OliWozniak/uMule/electronics/Układ odbiorników IR/Układ odbiorników IR.png

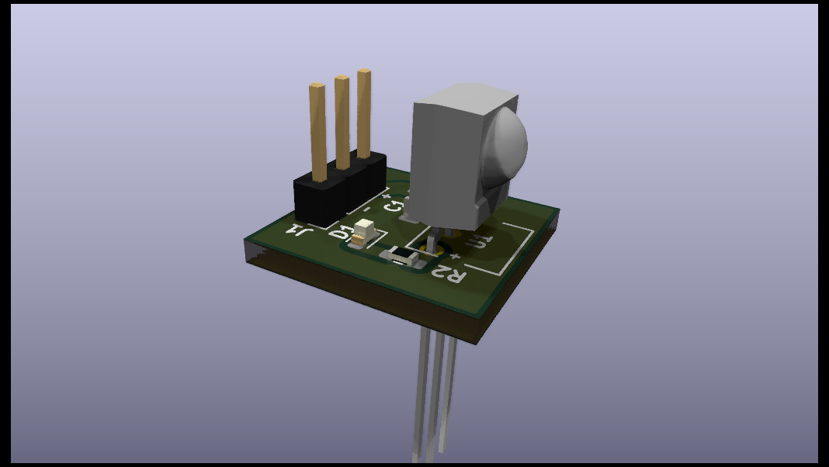
electronics/Układ odbiorników IR/Układ odbiorników IR.png
