OliWozniak/uMule/mechanics/subsets/attachments/raspberry_pi/raspberry-pi-5-case-4.snapshot.2/Perspective_4.jpg

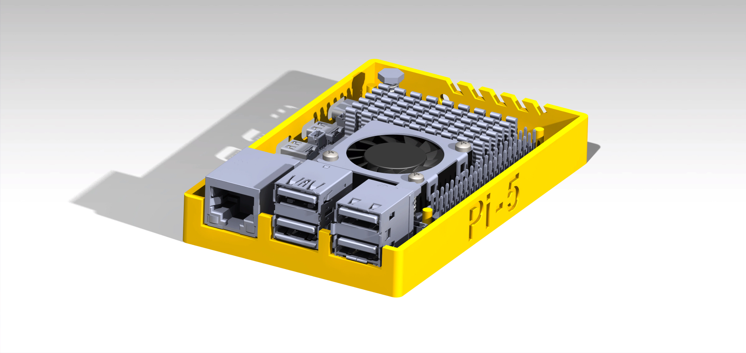
mechanics/subsets/attachments/raspberry_pi/raspberry-pi-5-case-4.snapshot.2/Perspective_4.jpg
