OliWozniak/uMule/electronics/Regulator_PD.drawio.pdf

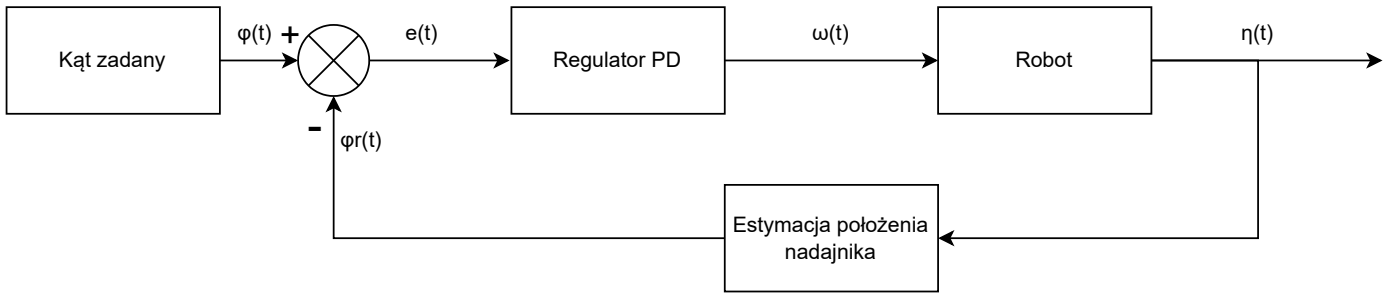
[picture p3: figure]
Estymacja położenia nadajnika; Regulator PD; Robot; Kąt zadany
