OliWozniak/uMule/electronics/Projekt elektroniki.png

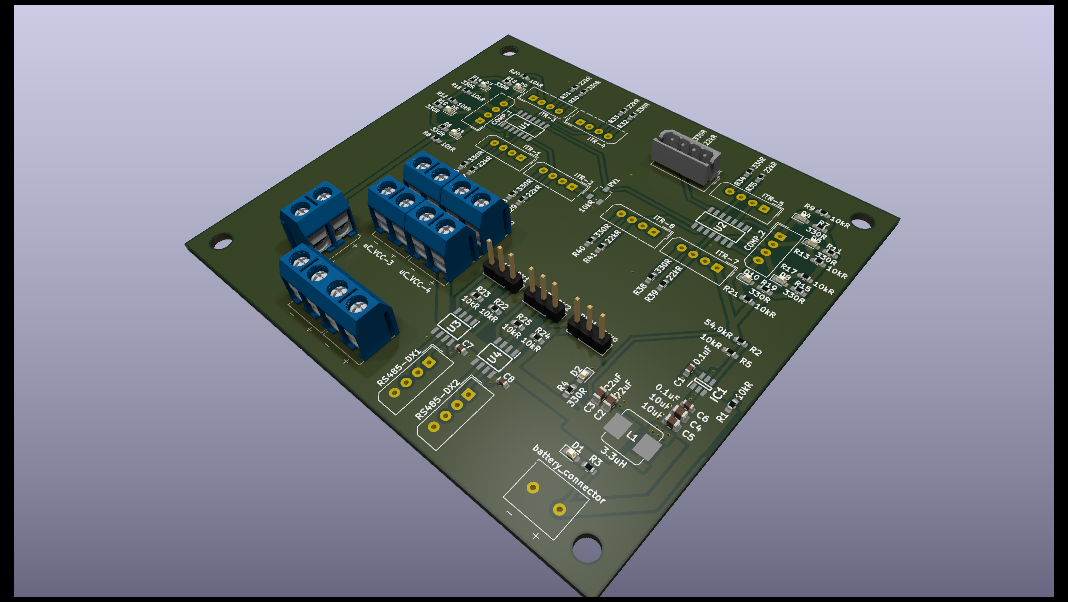
electronics/Projekt elektroniki.png
