OliWozniak/uMule/mechanics/hc-04-1.snapshot.5/HC-04.png

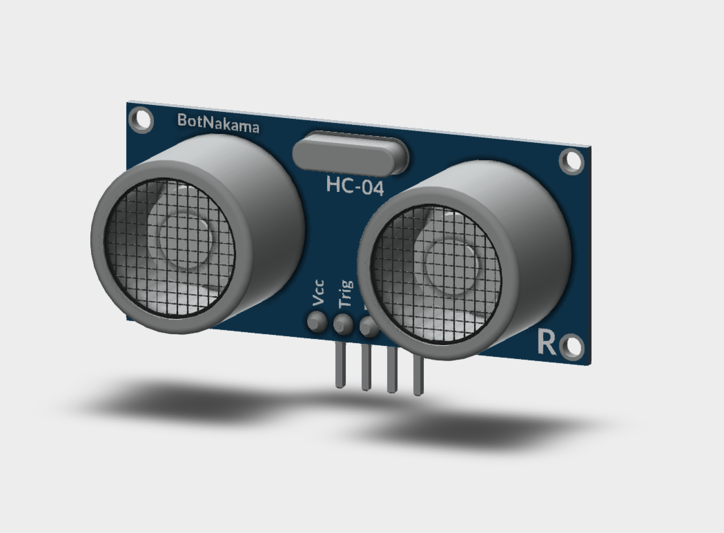
mechanics/hc-04-1.snapshot.5/HC-04.png
