OliWozniak/uMule/mechanics/subsets/attachments/raspberry_pi/raspberry-pi-5-case-4.snapshot.2/back-left.jpg

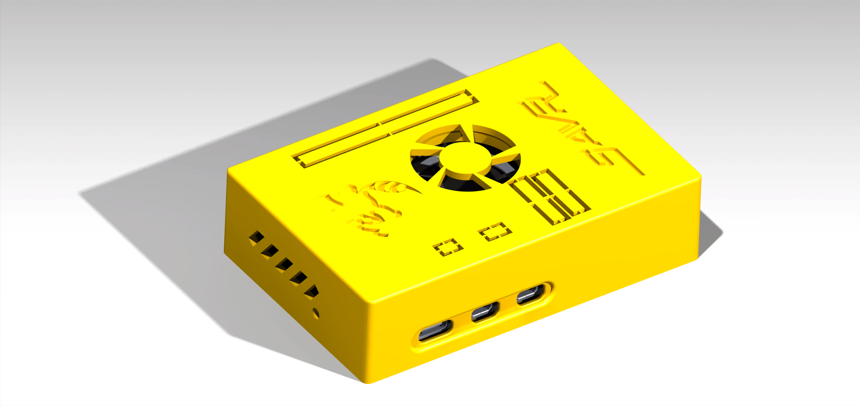
mechanics/subsets/attachments/raspberry_pi/raspberry-pi-5-case-4.snapshot.2/back-left.jpg
