OliWozniak/uMule/mechanics/subsets/power_pack/fg20451-lead-acid-battery-1.snapshot.1/FG20451.jpg

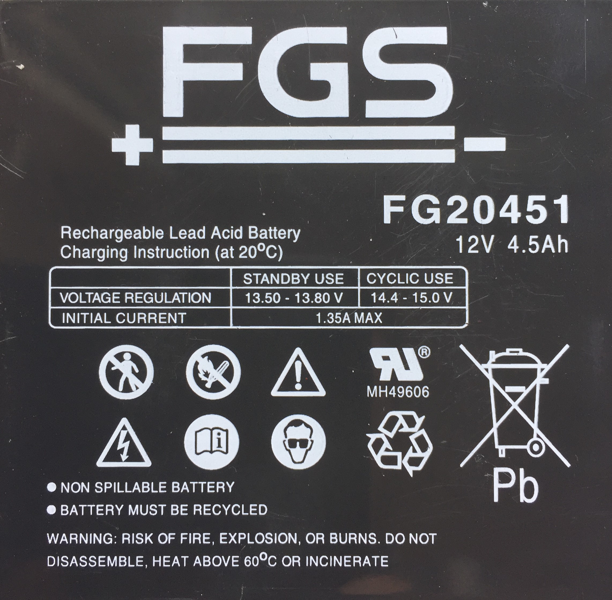
mechanics/subsets/power_pack/fg20451-lead-acid-battery-1.snapshot.1/FG20451.jpg
