OliWozniak/uMule/mechanics/subsets/attachments/raspberry_pi/Raspberry_PI+fan/raspberry-pi-5-active-cooler-1.snapshot.1/final_assembly.SLDASM

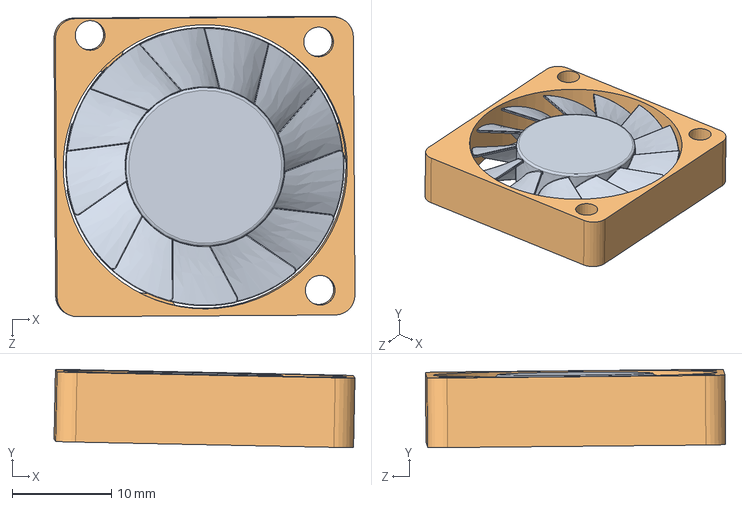
[picture p14: CAD file, 2026-05-02]
mechanics/subsets/attachments/raspberry_pi/Raspberry_PI+fan/raspberry-pi-5-active-cooler-1.snapshot.1/final_assembly.SLDASM
30.3 x 7.87 x 30.2 mm
RotorBlades
MotorHouse
