OliWozniak/uMule/mechanics/subsets/attachments/raspberry_pi/Raspberry_PI+fan/raspberry-pi-5-active-cooler-1.snapshot.1/Heatsink+fan RPi-5.SLDASM

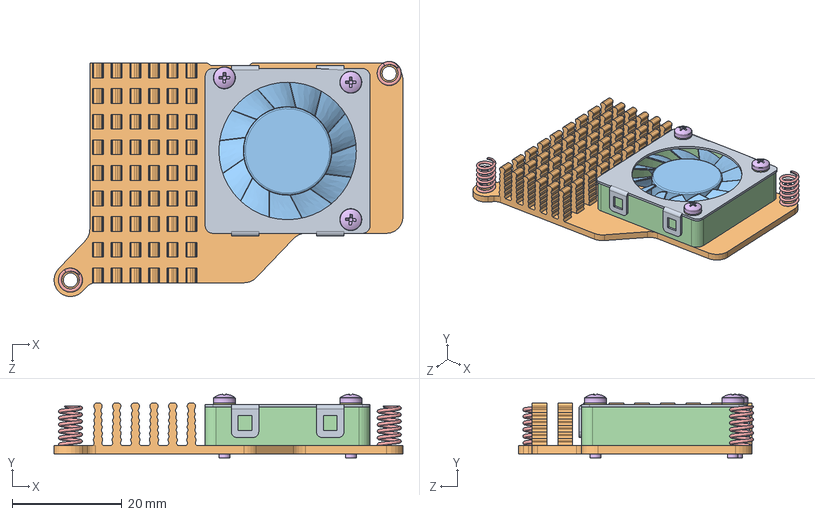
[picture p15: CAD file, 2026-05-02]
mechanics/subsets/attachments/raspberry_pi/Raspberry_PI+fan/raspberry-pi-5-active-cooler-1.snapshot.1/Heatsink+fan RPi-5.SLDASM
63.5 x 11.6 x 42.8 mm
Heatsink-fan-base_RPi5
RotorBlades
MotorHouse
fan cover
Spring x 2
pan head cross recess screw_din x 3
plain washer small grade a_din x 3
