OliWozniak/uMule/electronics/Importowane elementy/ARC_02-5mm/bornera.stp

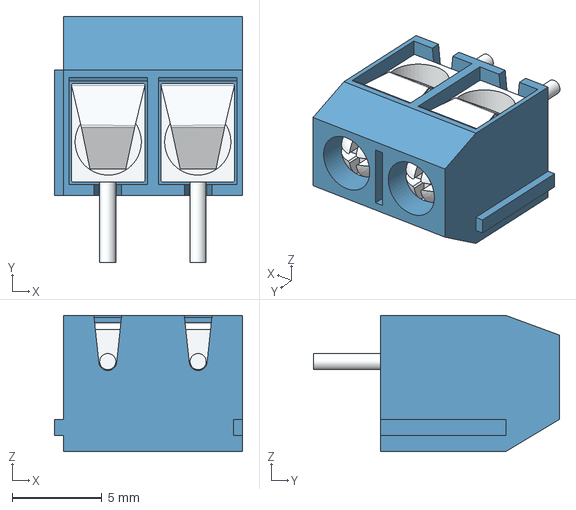
[picture p16: CAD file, 2024-11-24]
electronics/Importowane elementy/ARC_02-5mm/bornera.stp
10.5 x 13.8 x 7.60 mm
