OliWozniak/uMule/electronics/Importowane elementy/MAX485CSA+T/3D/MAX485CSA+T.stp

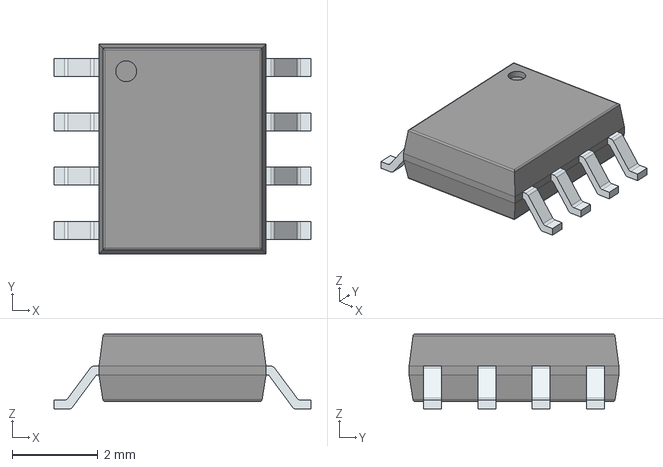
[picture p17: CAD file, 2024-11-24]
electronics/Importowane elementy/MAX485CSA+T/3D/MAX485CSA+T.stp
6.00 x 4.90 x 1.75 mm
PinsArrayLR
