OliWozniak/uMule/electronics/Importowane elementy/Molex-SPOX-04-2,5mm/3D/22-03-5045.stp

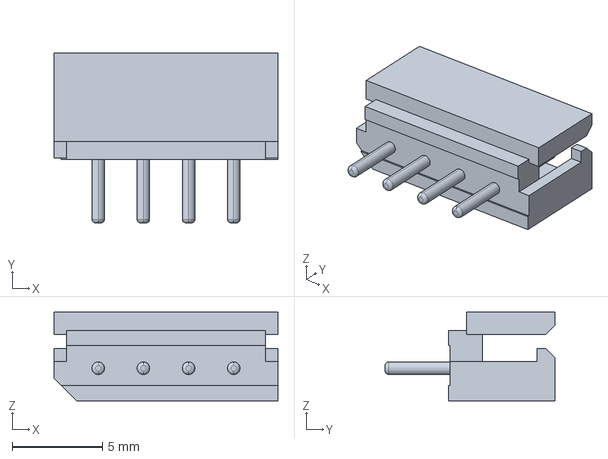
[picture p18: CAD file, 2024-11-24]
electronics/Importowane elementy/Molex-SPOX-04-2,5mm/3D/22-03-5045.stp
12.4 x 9.40 x 4.90 mm
