OliWozniak/uMule/electronics/Importowane elementy/TSOP4838/TSOP4838.stp

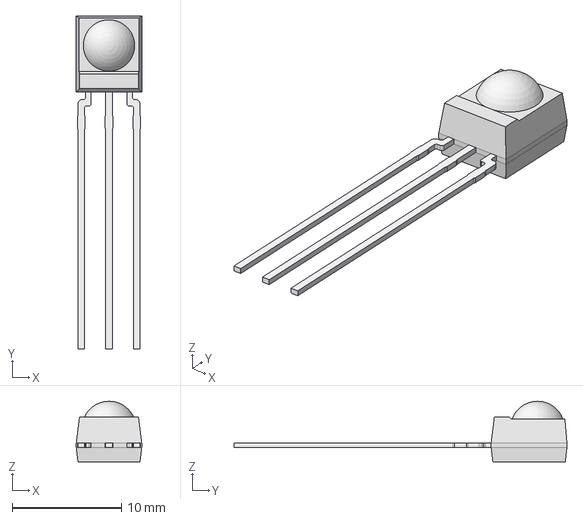
[picture p19: CAD file, 2024-11-24]
electronics/Importowane elementy/TSOP4838/TSOP4838.stp
6.00 x 30.5 x 5.55 mm
GO-100184
GO-100184.04
