OliWozniak/uMule/mechanics/hc-04-1.snapshot.5/HC-04HC-04.stl

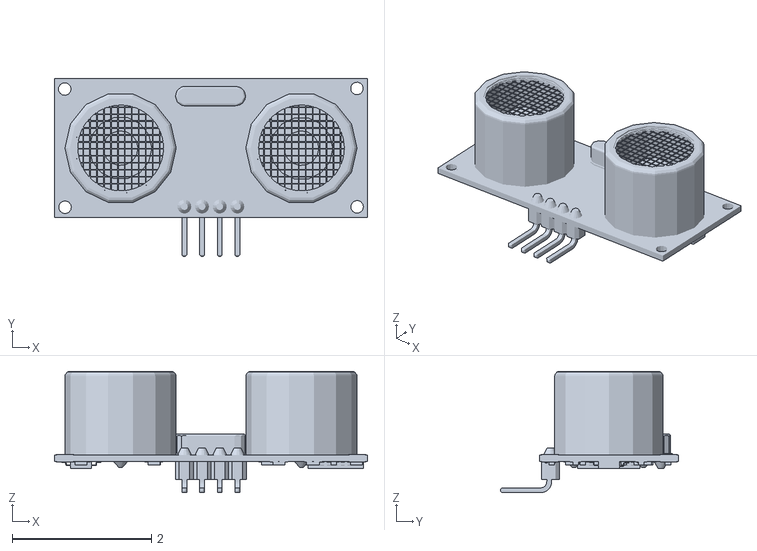
[picture p20: CAD file, 2024-11-24]
mechanics/hc-04-1.snapshot.5/HC-04HC-04.stl
4.50 x 2.56 x 1.75
