OliWozniak/uMule/mechanics/subsets/attachments/camera/camera_holder.step

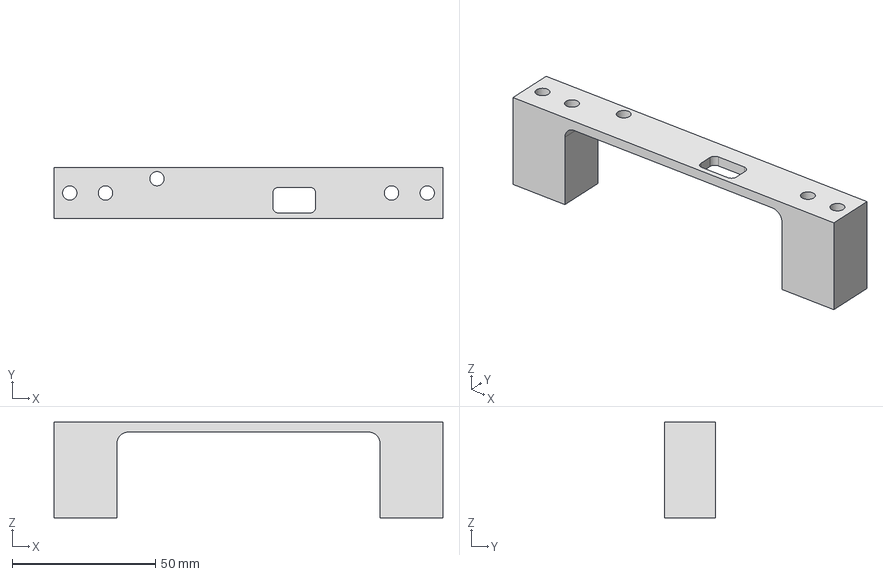
[picture p21: CAD file, 2026-05-04]
mechanics/subsets/attachments/camera/camera_holder.step
136.0 x 18.0 x 33.5 mm
