OliWozniak/uMule/mechanics/subsets/attachments/hub/attachments_hub.stp

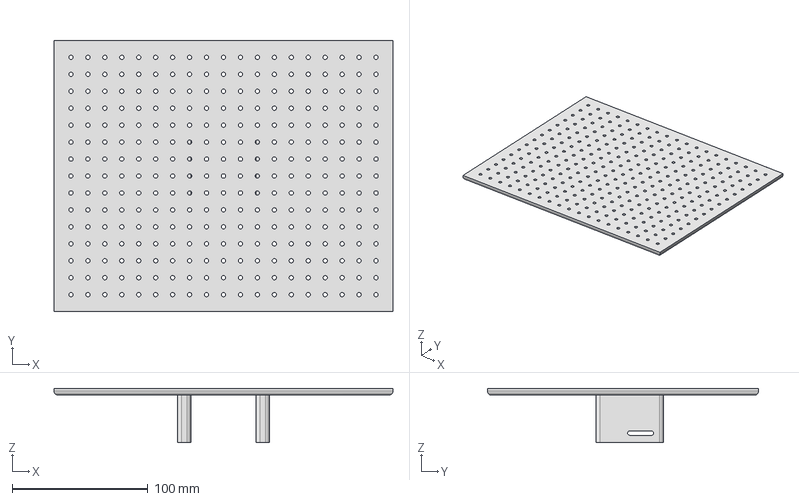
[picture p22: CAD file, 2026-05-04]
mechanics/subsets/attachments/hub/attachments_hub.stp
250.0 x 200.0 x 40.0 mm
