OliWozniak/uMule/mechanics/subsets/attachments/lidar/lidar_holder.stp

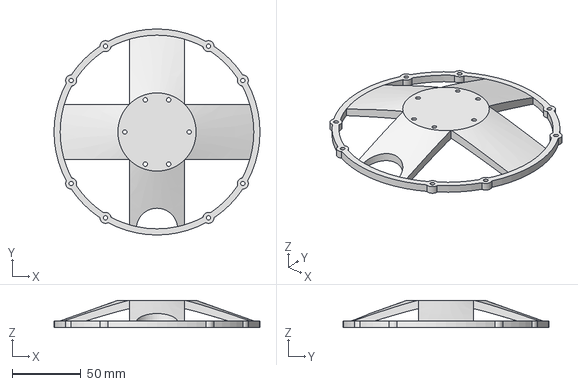
[picture p23: CAD file, 2026-05-04]
mechanics/subsets/attachments/lidar/lidar_holder.stp
150.0 x 150.0 x 20.0 mm
