OliWozniak/uMule/mechanics/subsets/attachments/main_board/board_holder.stp

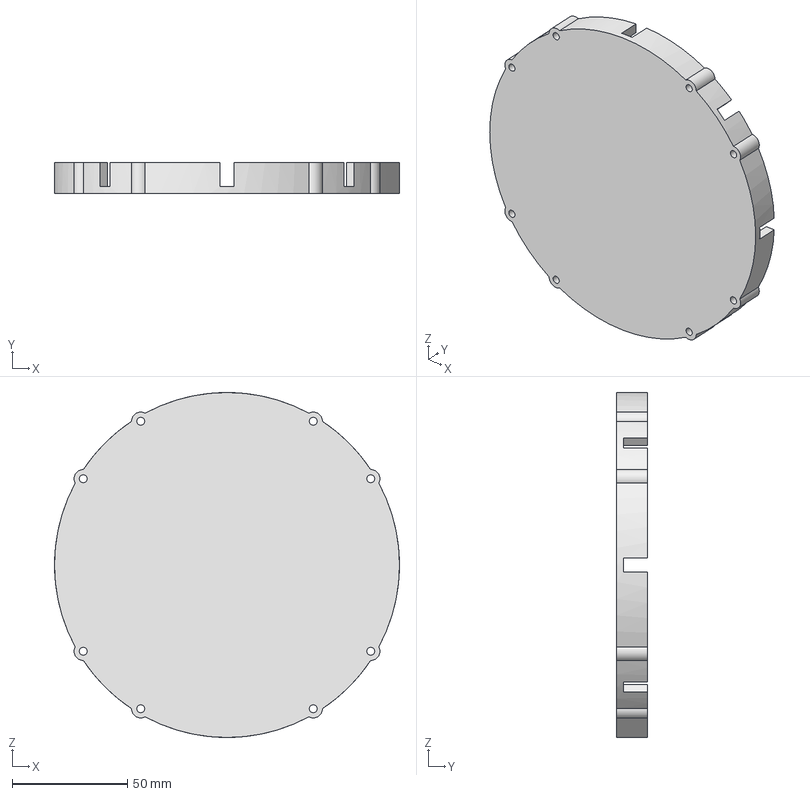
[picture p24: CAD file, 2026-05-04]
mechanics/subsets/attachments/main_board/board_holder.stp
150.0 x 13.5 x 150.0 mm
