OliWozniak/uMule/mechanics/subsets/attachments/print_files/RPi_case_bottom.stl

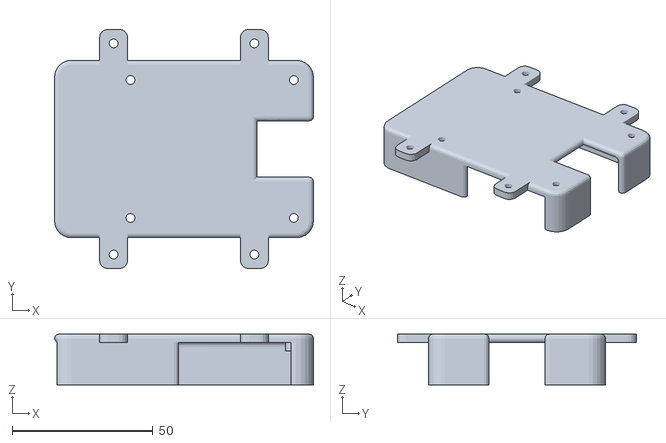
[picture p25: CAD file, 2026-05-04]
mechanics/subsets/attachments/print_files/RPi_case_bottom.stl
92.0 x 85.0 x 18.0
