OliWozniak/uMule/mechanics/subsets/attachments/raspberry_pi/raspberry-pi-5-case-4.snapshot.2/top.step

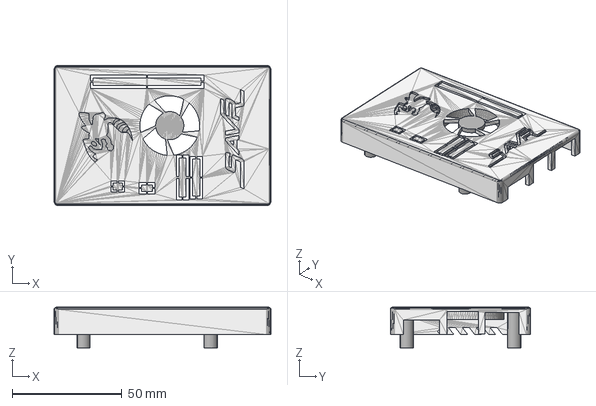
[picture p26: CAD file, 2026-05-04]
mechanics/subsets/attachments/raspberry_pi/raspberry-pi-5-case-4.snapshot.2/top.step
99.0 x 64.0 x 18.5 mm
