OliWozniak/uMule/mechanics/subsets/attachments/raspberry_pi/Raspberry_PI+fan/raspberry-pi-5-active-cooler-1.snapshot.1/Heatsink-fan-base_RPi5.SLDPRT

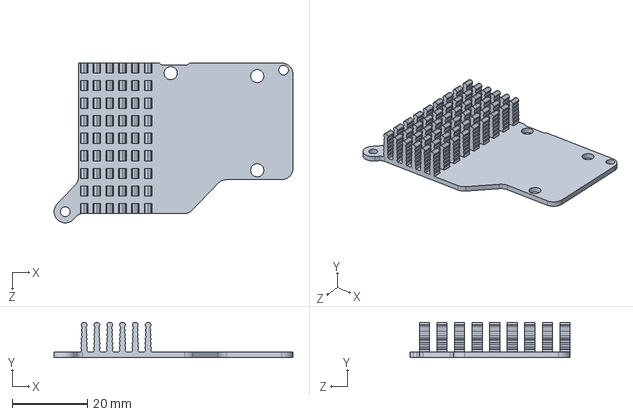
[picture p27: CAD file, 2026-05-02]
mechanics/subsets/attachments/raspberry_pi/Raspberry_PI+fan/raspberry-pi-5-active-cooler-1.snapshot.1/Heatsink-fan-base_RPi5.SLDPRT
63.5 x 9.30 x 42.5 mm
