OliWozniak/uMule/mechanics/subsets/attachments/print_files/lidar_holder.stl

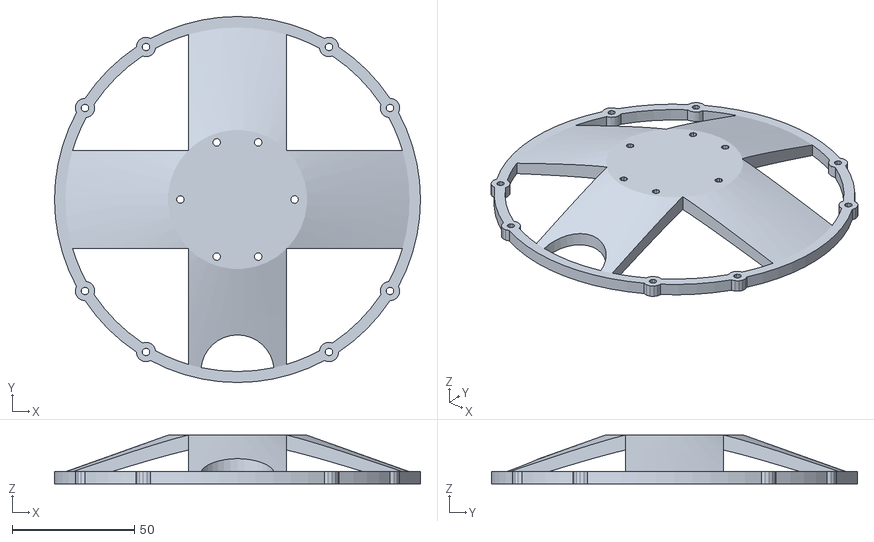
[picture p28: CAD file, 2026-05-04]
mechanics/subsets/attachments/print_files/lidar_holder.stl
150.0 x 150.0 x 20.0
