OliWozniak/uMule/mechanics/subsets/attachments/raspberry_pi/Raspberry_PI+fan/raspberry-pi-5-active-cooler-1.snapshot.1/MotorHouse.SLDPRT

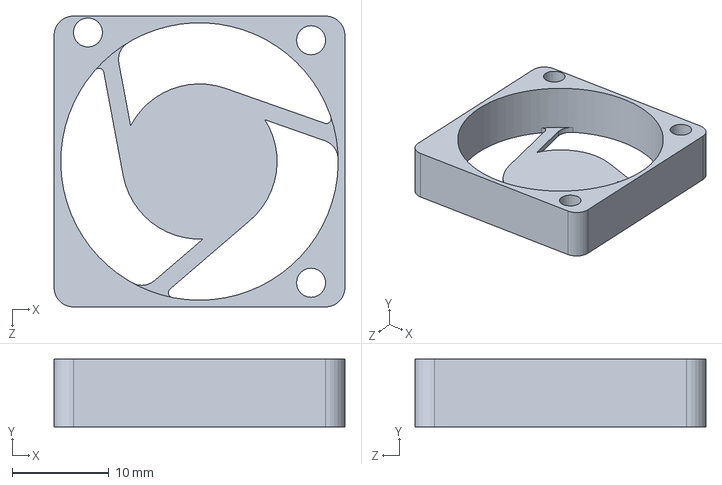
[picture p30: CAD file, 2026-05-02]
mechanics/subsets/attachments/raspberry_pi/Raspberry_PI+fan/raspberry-pi-5-active-cooler-1.snapshot.1/MotorHouse.SLDPRT
30.0 x 7.00 x 30.0 mm
