OliWozniak/uMule/mechanics/subsets/attachments/raspberry_pi/Raspberry_PI+fan/raspberry-pi-5-active-cooler-1.snapshot.1/fan cover.SLDPRT

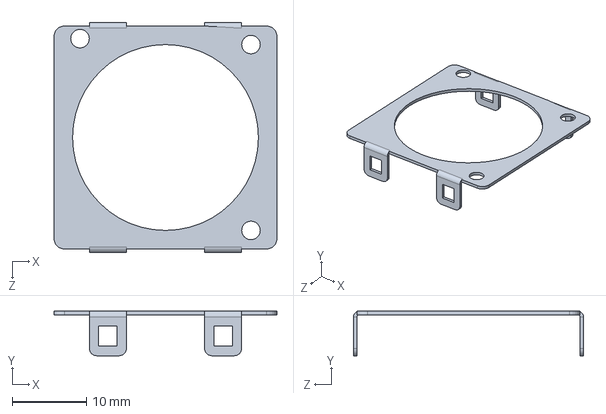
[picture p31: CAD file, 2026-05-02]
mechanics/subsets/attachments/raspberry_pi/Raspberry_PI+fan/raspberry-pi-5-active-cooler-1.snapshot.1/fan cover.SLDPRT
30.0 x 6.00 x 31.0 mm
