OliWozniak/uMule/(list of files, cad)

Other CAD files:
mechanics/subsets/attachments/raspberry_pi/RPi_case_bottom.stp
mechanics/subsets/attachments/print_files/board_holder.stl
mechanics/subsets/attachments/print_files/camera_holder.stl
mechanics/subsets/attachments/print_files/attachments_hub.stl
electronics/Importowane elementy/ARC_02-5mm/bornera.SLDPRT
mechanics/OldVersions/Część1.0002.ipt
mechanics/OldVersions/Pręt.0002.ipt
mechanics/OldVersions/pręt_długi.0002.ipt
mechanics/OldVersions/uMule-Koło.0018.iam
mechanics/OldVersions/uMule-UDaR-main_gear.0006.ipt
mechanics/OldVersions/uMule-UDaR-sensor.0003.ipt
mechanics/OldVersions/uMule-UDaR.0023.iam
mechanics/OldVersions/uMule-Uchwyt_koła.0004.ipt
mechanics/OldVersions/uMule-battery_case.0011.ipt
mechanics/OldVersions/uMule-battery_cover.0002.ipt
mechanics/OldVersions/uMule-elektronika.0008.iam
mechanics/OldVersions/uMule-kolo_napędowe.0004.ipt
mechanics/OldVersions/uMule-ogranicznik_koła.0012.ipt
mechanics/OldVersions/uMule-podstawa_elektronika-V1.1.0001.ipt
mechanics/OldVersions/uMule-podstawa_elektronika.0012.ipt
mechanics/OldVersions/uMule-podstawka_czujnikiIR.0006.ipt
mechanics/OldVersions/uMule-uchwyt_dx.0002.ipt
mechanics/OldVersions/uMule-uchwyt_dx_góra.0011.ipt
mechanics/OldVersions/uMule-uchwyt_servo.0004.ipt
mechanics/OldVersions/uMule_uchwyt-sens.0032.ipt
mechanics/subsets/attachments/camera/OldVersions/camera_assembly.0001.iam
mechanics/subsets/attachments/camera/OldVersions/camera_holder.0015.ipt
mechanics/subsets/attachments/camera/camera_assembly.iam
mechanics/subsets/attachments/camera/camera_holder.ipt
mechanics/subsets/attachments/camera/camera_model.ipt
mechanics/subsets/attachments/hub/OldVersions/attachments_hub.0010.ipt
mechanics/subsets/attachments/hub/attachments_hub.ipt
mechanics/subsets/attachments/lidar/LD19_v2/STL-19P_LiDaRLD19_PCB.ipt
mechanics/subsets/attachments/lidar/LD19_v2/STL-19P_LiDaRLD19_bottom.ipt
mechanics/subsets/attachments/lidar/LD19_v2/STL-19P_LiDaRLD19_middle.ipt
mechanics/subsets/attachments/lidar/LD19_v2/STL-19P_LiDaRLD19_up.ipt
mechanics/subsets/attachments/lidar/LD19_v2/STL-19P_LiDaRLD19_v2.iam
mechanics/subsets/attachments/lidar/LD19_v2/STL-19P_LiDaRPA2X6_1.ipt
mechanics/subsets/attachments/lidar/LD19_v2/STL-19P_LiDaRPA2X6_2.ipt
mechanics/subsets/attachments/lidar/LD19_v2/STL-19P_LiDaRPA2X6_3.ipt
mechanics/subsets/attachments/lidar/LD19_v2/STL-19P_LiDaRPA2X6_4.ipt
mechanics/subsets/attachments/lidar/OldVersions/lidar_holder.0005.ipt
mechanics/subsets/attachments/lidar/lidar_holder.ipt
mechanics/subsets/attachments/main_board/OldVersions/board_holder.0007.ipt
mechanics/subsets/attachments/main_board/OldVersions/main_board.0006.iam
mechanics/subsets/attachments/main_board/board_holder.ipt
mechanics/subsets/attachments/main_board/main_board.iam
mechanics/subsets/attachments/main_board/uMule_board/.step 1.21.1.ipt
mechanics/subsets/attachments/main_board/uMule_board/AO_DFN-8-1EP_5.55x5.2mm_P1.27mm_EP4.12x4.6mm.iam
mechanics/subsets/attachments/main_board/uMule_board/CP_EIA-3528-21_Kemet-B.ipt
mechanics/subsets/attachments/main_board/uMule_board/C_0402_1005Metric.ipt
mechanics/subsets/attachments/main_board/uMule_board/C_0603_1608Metric.ipt
mechanics/subsets/attachments/main_board/uMule_board/C_0805_2012Metric.ipt
mechanics/subsets/attachments/main_board/uMule_board/Crystal_SMD_5032-2Pin_5.0x3.2mm.ipt
mechanics/subsets/attachments/main_board/uMule_board/D_SMA.ipt
mechanics/subsets/attachments/main_board/uMule_board/D_SOD-123F.ipt
mechanics/subsets/attachments/main_board/uMule_board/JST_XH_B4B-XH-A_1x04_P2.50mm_Vertical.ipt
mechanics/subsets/attachments/main_board/uMule_board/JST_XH_B6B-XH-A_1x06_P2.50mm_Vertical.ipt
mechanics/subsets/attachments/main_board/uMule_board/LED_0603_1608Metric.ipt
mechanics/subsets/attachments/main_board/uMule_board/LQFP-64_10x10mm_P0.5mm.ipt
mechanics/subsets/attachments/main_board/uMule_board/PhoenixContact_MCV_1,5_2-G-3.5_1x02_P3.50mm_Vertical.ipt
mechanics/subsets/attachments/main_board/uMule_board/PinHeader_1x04_P2.54mm_Vertical.ipt
mechanics/subsets/attachments/main_board/uMule_board/PinHeader_2x04_P2.54mm_Vertical.ipt
mechanics/subsets/attachments/main_board/uMule_board/PinHeader_2x07_P1.27mm_Vertical.ipt
mechanics/subsets/attachments/main_board/uMule_board/R_0603_1608Metric.ipt
mechanics/subsets/attachments/main_board/uMule_board/SOIC-8_3.9x4.9mm_P1.27mm.ipt
mechanics/subsets/attachments/main_board/uMule_board/SOT-223.ipt
mechanics/subsets/attachments/main_board/uMule_board/SOT-23-5.ipt
mechanics/subsets/attachments/main_board/uMule_board/SOT-23.ipt
mechanics/subsets/attachments/main_board/uMule_board/SOT-583-8.ipt
mechanics/subsets/attachments/main_board/uMule_board/SW_SPST_TL3342.ipt
mechanics/subsets/attachments/main_board/uMule_board/uMule_board.iam
mechanics/subsets/attachments/main_board/uMule_board/uMule_board_PCB.ipt
mechanics/subsets/attachments/main_board/uMule_board/uMule_board_silkscreen.ipt
mechanics/subsets/attachments/main_board/uMule_board/uMule_board_silkscreen_1.ipt
mechanics/subsets/attachments/main_board/uMule_board/uMule_board_soldermask.ipt
mechanics/subsets/attachments/main_board/uMule_board/uMule_board_soldermask_1.ipt
mechanics/subsets/attachments/raspberry_pi/OldVersions/RPI_assembly.0004.iam
mechanics/subsets/attachments/raspberry_pi/OldVersions/RPi_case_bottom.0008.ipt
mechanics/subsets/attachments/raspberry_pi/RPI_assembly.iam
mechanics/subsets/attachments/raspberry_pi/RPi_case_bottom.ipt
mechanics/subsets/attachments/raspberry_pi/Raspberry_PI+fan/RASPBERRY_PI_5_1/2.0_PIN_HEADER.ipt
mechanics/subsets/attachments/raspberry_pi/Raspberry_PI+fan/RASPBERRY_PI_5_1/2xUSB_2.0_PORT.ipt
mechanics/subsets/attachments/raspberry_pi/Raspberry_PI+fan/RASPBERRY_PI_5_1/2xUSB_3.0_PORT.ipt
mechanics/subsets/attachments/raspberry_pi/Raspberry_PI+fan/RASPBERRY_PI_5_1/3.0_PIN_HEADER_10.ipt
mechanics/subsets/attachments/raspberry_pi/Raspberry_PI+fan/RASPBERRY_PI_5_1/9FD77_D9WHV.ipt
mechanics/subsets/attachments/raspberry_pi/Raspberry_PI+fan/RASPBERRY_PI_5_1/BROADCOM_1.ipt
mechanics/subsets/attachments/raspberry_pi/Raspberry_PI+fan/RASPBERRY_PI_5_1/BUTTON_2.ipt
mechanics/subsets/attachments/raspberry_pi/Raspberry_PI+fan/RASPBERRY_PI_5_1/BUTTON_MINI.ipt
mechanics/subsets/attachments/raspberry_pi/Raspberry_PI+fan/RASPBERRY_PI_5_1/CAMERA_DISPLAY_1.ipt
mechanics/subsets/attachments/raspberry_pi/Raspberry_PI+fan/RASPBERRY_PI_5_1/CAMERA_DISPLAY_2.ipt
mechanics/subsets/attachments/raspberry_pi/Raspberry_PI+fan/RASPBERRY_PI_5_1/CARD_SLOT_METAL_PIN.ipt
mechanics/subsets/attachments/raspberry_pi/Raspberry_PI+fan/RASPBERRY_PI_5_1/CONNECT_V1.ipt
mechanics/subsets/attachments/raspberry_pi/Raspberry_PI+fan/RASPBERRY_PI_5_1/FEMALE_MICRO_HDMI_CONNECTOR.ipt
mechanics/subsets/attachments/raspberry_pi/Raspberry_PI+fan/RASPBERRY_PI_5_1/FEMALE_USB_CONNECTOR.ipt
mechanics/subsets/attachments/raspberry_pi/Raspberry_PI+fan/RASPBERRY_PI_5_1/GIGABIT_ETHERNET_PORT.ipt
mechanics/subsets/attachments/raspberry_pi/Raspberry_PI+fan/RASPBERRY_PI_5_1/GIGABIT_ETHERNET_TRANSCEIVE.ipt
mechanics/subsets/attachments/raspberry_pi/Raspberry_PI+fan/RASPBERRY_PI_5_1/Logo raspberry.ipt
mechanics/subsets/attachments/raspberry_pi/Raspberry_PI+fan/RASPBERRY_PI_5_1/METAL_PLATE..ipt
mechanics/subsets/attachments/raspberry_pi/Raspberry_PI+fan/RASPBERRY_PI_5_1/MxL.ipt
mechanics/subsets/attachments/raspberry_pi/Raspberry_PI+fan/RASPBERRY_PI_5_1/PART3_V1.ipt
mechanics/subsets/attachments/raspberry_pi/Raspberry_PI+fan/RASPBERRY_PI_5_1/PLATE_RASPBERRY_PI_5.ipt
mechanics/subsets/attachments/raspberry_pi/Raspberry_PI+fan/RASPBERRY_PI_5_1/RASPBERRY_PI_5_1.iam
mechanics/subsets/attachments/raspberry_pi/Raspberry_PI+fan/RASPBERRY_PI_5_1/RP1_CO_CONTROLLER.ipt
mechanics/subsets/attachments/raspberry_pi/Raspberry_PI+fan/RASPBERRY_PI_5_1/SD_CARD_V1.ipt
mechanics/subsets/attachments/raspberry_pi/Raspberry_PI+fan/RASPBERRY_PI_5_1/SLOT_CARD_ASM.iam
mechanics/subsets/attachments/raspberry_pi/Raspberry_PI+fan/RASPBERRY_PI_5_1/STOCK_1.ipt
mechanics/subsets/attachments/raspberry_pi/Raspberry_PI+fan/RASPBERRY_PI_5_1/STOCK_2.ipt
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
