OliWozniak/uMule/electronics/Układ odbiorników IR/Układ odbiorników IR.kicad_pcb

## KiCad design electronics/Układ odbiorników IR/Układ odbiorników IR.kicad_pcb (2024-11-24)

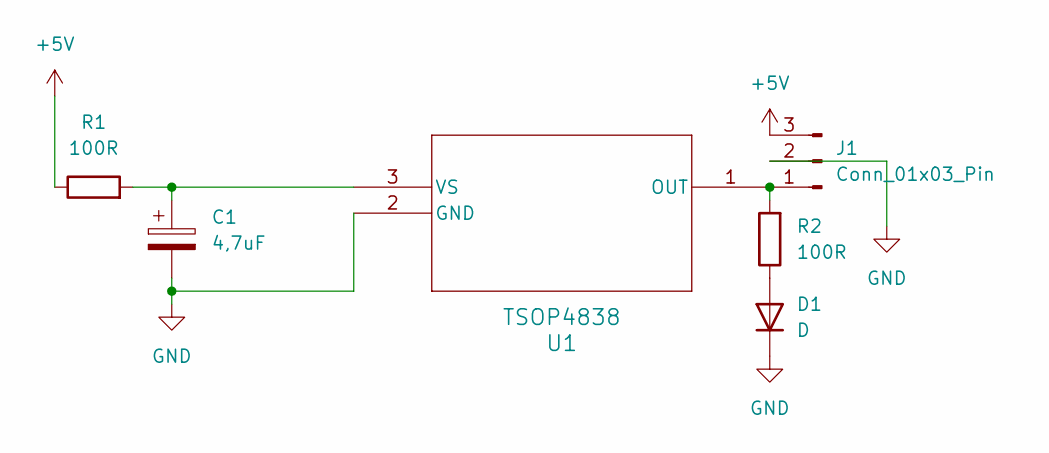
[picture p39: schematic Układ odbiorników IR.kicad_sch]

Parts:
C1: 4,7uF; C_0805_2012Metric_Pad1.18x1.45mm_HandSolder
D1: D; LED_0603_1608Metric
J1: Conn_01x03_Pin; PinHeader_1x03_P2.54mm_Vertical
R1, R2: 100R; R_0603_1608Metric_Pad0.98x0.95mm_HandSolder
U1: TSOP4838; TSOP48_VIS

Connections:
+5V: J1.3, R1.1
GND: C1.2, D1.1 (K), J1.2, U1.2 (GND)
unnamed: D1.2 (A), R2.1
unnamed: J1.1, R2.2, U1.1 (OUT)
unnamed: C1.1, R1.2, U1.3 (VS)

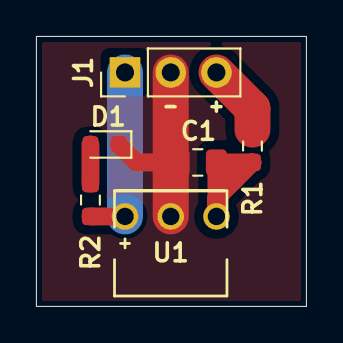
[picture p40: board Układ odbiorników IR.kicad_pcb from above]

Board: 2 copper layers, 15.0 x 15.0 mm, 6 parts (0 on the bottom side), 5 nets.
