OliWozniak/uMule/electronics/Projekt elektroniki.kicad_pcb

## KiCad design electronics/Projekt elektroniki.kicad_pcb (2024-11-24)

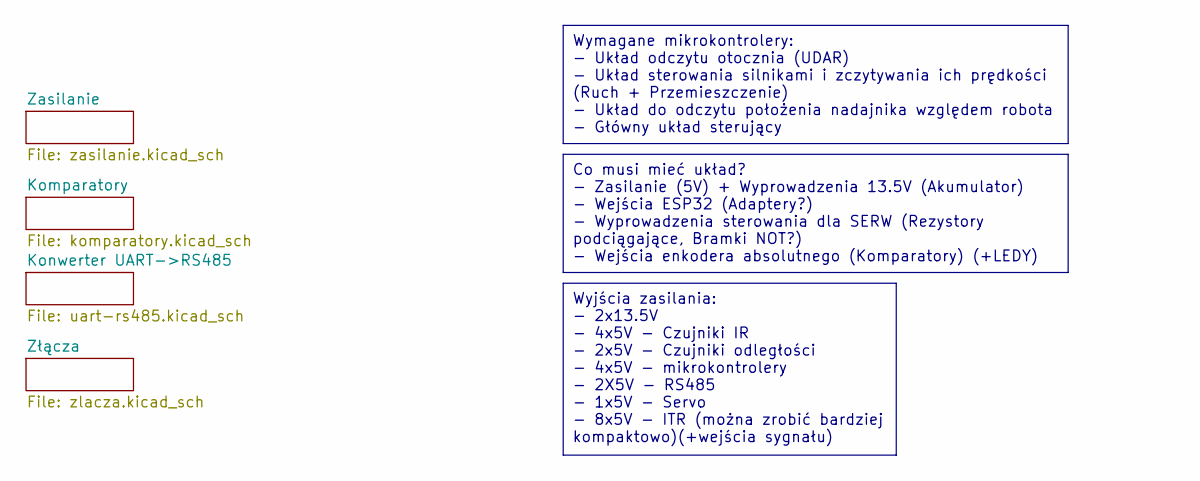
[picture p41: schematic Projekt elektroniki.kicad_sch]

Notes on the sheet:
Wyjścia zasilania: - 2x13.5V - 4x5V - Czujniki IR - 2x5V - Czujniki odległości - 4x5V - mikrokontrolery - 2X5V - RS485 - 1x5V - Servo - 8x5V - ITR (można zrobić bardziej kompaktowo)(+wejścia sygnału)
Wymagane mikrokontrolery: - Układ odczytu otocznia (UDAR) - Układ sterowania silnikami i zczytywania ich prędkości (Ruch + Przemieszczenie) - Układ do odczytu położenia nadajnika względem robota - Główny układ sterujący
Co musi mieć układ? - Zasilanie (5V) + Wyprowadzenia 13.5V (Akumulator) - Wejścia ESP32 (Adaptery?) - Wyprowadzenia sterowania dla SERW (Rezystory podciągające, Bramki NOT?) - Wejścia enkodera absolutnego (Komparatory) (+LEDY)

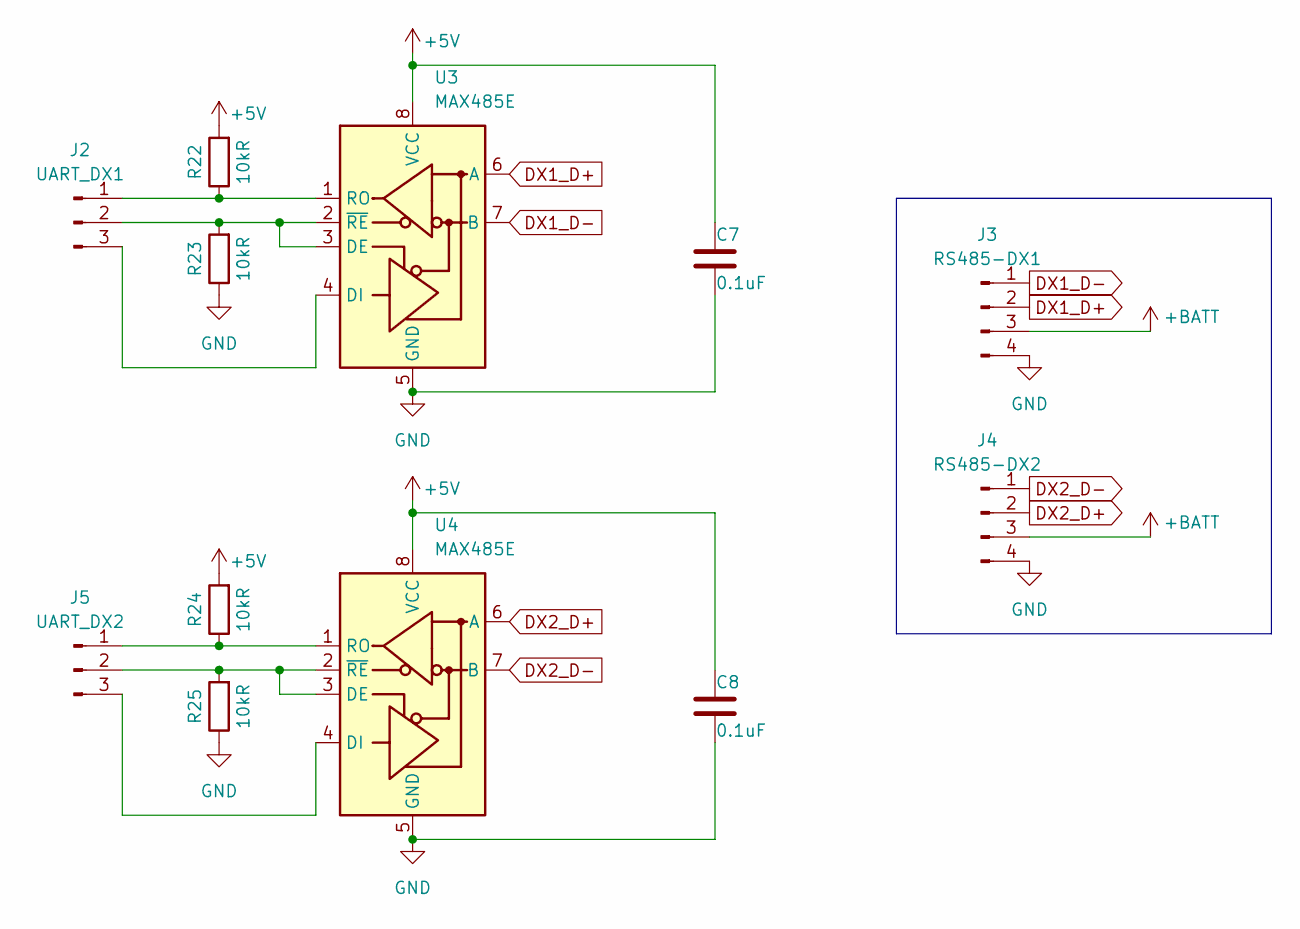
[picture p42: schematic uart-rs485.kicad_sch]

Parts:
C7, C8: 0.1uF; C_0603_1608Metric
J2: UART_DX1; PinHeader_1x03_P2.54mm_Vertical
J3: RS485-DX1; Molex_SPOX_5267-04A_1x04_P2.50mm_Vertical
J4: RS485-DX2; Molex_SPOX_5267-04A_1x04_P2.50mm_Vertical
J5: UART_DX2; PinHeader_1x03_P2.54mm_Vertical
R22, R23, R24, R25: 10kR; R_0603_1608Metric_Pad0.98x0.95mm_HandSolder
U3, U4: MAX485E; SOIC127P600X175-8N (MAX485)

Connections:
+5V: C7.2, C8.2, R22.2, R24.2, U3.8 (VCC), U4.8 (VCC); also elsewhere on the board
DX1_D+: J3.2, U3.6 (A)
DX1_D-: J3.1, U3.7 (B)
DX2_D+: J4.2, U4.6 (A)
DX2_D-: J4.1, U4.7 (B)
GND: C7.1, C8.1, J3.4, J4.4, R23.1, R25.1, U3.5 (GND), U4.5 (GND); also elsewhere on the board
unnamed: J2.1, R22.1, U3.1 (RO)
unnamed: J2.2, R23.2, U3.2 (~RE), U3.3 (DE)
unnamed: J2.3, U3.4 (DI)
unnamed: J5.1, R24.1, U4.1 (RO)
unnamed: J5.2, R25.2, U4.2 (~RE), U4.3 (DE)
unnamed: J5.3, U4.4 (DI)
Przetwornica_VIN: J3.3, J4.3; also elsewhere on the board

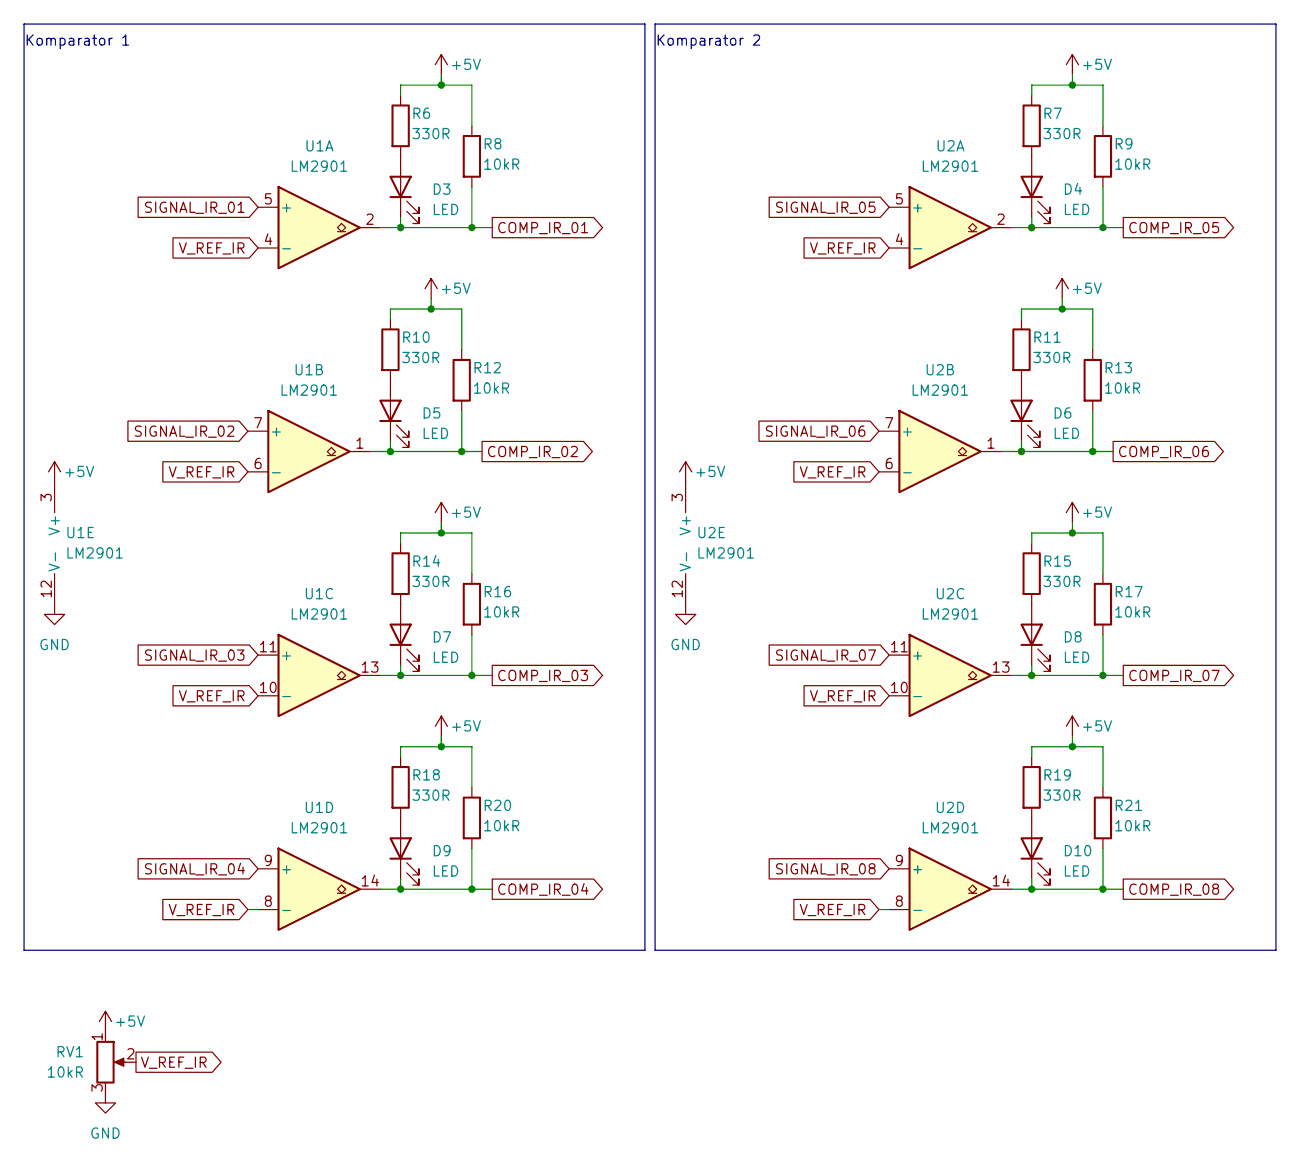
[picture p43: schematic komparatory.kicad_sch]

Parts:
D3, D4, D5, D6, D7, D8, D9, D10: LED; LED_0603_1608Metric_Pad1.05x0.95mm_HandSolder
R6, R7, R10, R11, R14, R15, R18, R19: 330R; R_0603_1608Metric_Pad0.98x0.95mm_HandSolder
R8, R9, R12, R13, R16, R17, R20, R21: 10kR; R_0603_1608Metric_Pad0.98x0.95mm_HandSolder
RV1: 10kR; Potencjometr 3,2x3,4
U1, U2: LM2901; SOIC127P600X175-14N

Connections:
+5V: R6.1, R7.1, R8.1, R9.1, R10.1, R11.1, R12.1, R13.1, R14.1, R15.1, R16.1, R17.1, R18.1, R19.1, R20.1, R21.1, RV1.1, U1.3 (V+), U2.3 (V+); also elsewhere on the board
COMP_IR_01: D3.1 (K), R8.2, U1.2; also elsewhere on the board
COMP_IR_02: D5.1 (K), R12.2, U1.1; also elsewhere on the board
COMP_IR_03: D7.1 (K), R16.2, U1.13; also elsewhere on the board
COMP_IR_04: D9.1 (K), R20.2, U1.14; also elsewhere on the board
COMP_IR_05: D4.1 (K), R9.2, U2.2; also elsewhere on the board
COMP_IR_06: D6.1 (K), R13.2, U2.1; also elsewhere on the board
COMP_IR_07: D8.1 (K), R17.2, U2.13; also elsewhere on the board
COMP_IR_08: D10.1 (K), R21.2, U2.14; also elsewhere on the board
GND: RV1.3, U1.12 (V-), U2.12 (V-); also elsewhere on the board
unnamed: D3.2 (A), R6.2
unnamed: D4.2 (A), R7.2
unnamed: D5.2 (A), R10.2
unnamed: D6.2 (A), R11.2
unnamed: D7.2 (A), R14.2
unnamed: D8.2 (A), R15.2
unnamed: D9.2 (A), R18.2
unnamed: D10.2 (A), R19.2
SIGNAL_IR_01: U1.5 (+); also elsewhere on the board
SIGNAL_IR_02: U1.7 (+); also elsewhere on the board
SIGNAL_IR_03: U1.11 (+); also elsewhere on the board
SIGNAL_IR_04: U1.9 (+); also elsewhere on the board
SIGNAL_IR_05: U2.5 (+); also elsewhere on the board
SIGNAL_IR_06: U2.7 (+); also elsewhere on the board
SIGNAL_IR_07: U2.11 (+); also elsewhere on the board
SIGNAL_IR_08: U2.9 (+); also elsewhere on the board
V_REF_IR: RV1.2, U1.4 (-), U1.6 (-), U1.8 (-), U1.10 (-), U2.4 (-), U2.6 (-), U2.8 (-), U2.10 (-)

Notes on the sheet:
Komparator 2
Komparator 1

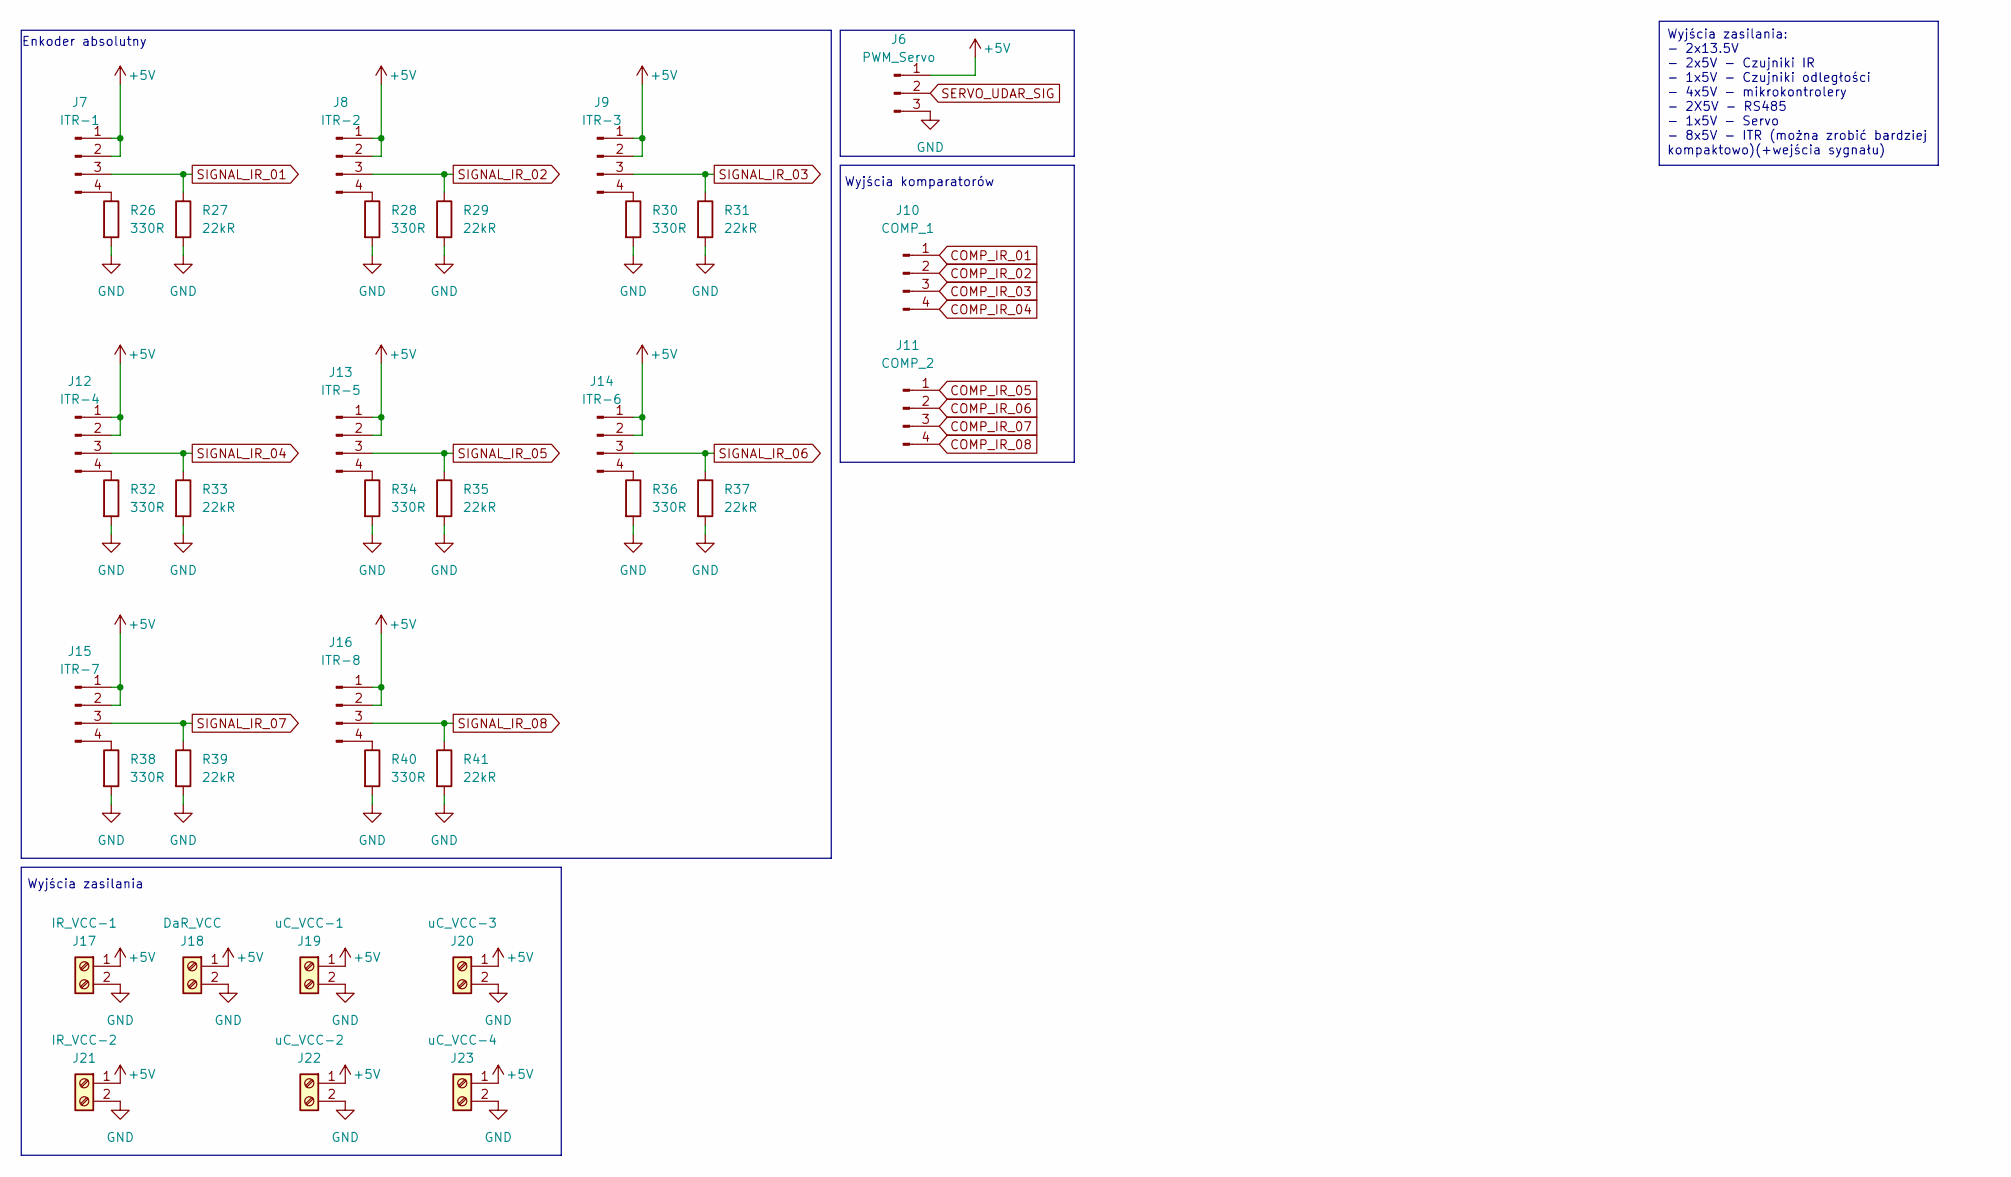
[picture p44: schematic zlacza.kicad_sch]

Parts:
J6: PWM_Servo; PinHeader_1x03_P2.54mm_Vertical
J7: ITR-1; Molex_SPOX_5267-04A_1x04_P2.50mm_Vertical
J8: ITR-2; Molex_SPOX_5267-04A_1x04_P2.50mm_Vertical
J9: ITR-3; Molex_SPOX_5267-04A_1x04_P2.50mm_Vertical
J10: COMP_1; Molex_SPOX_5267-04A_1x04_P2.50mm_Vertical
J11: COMP_2; Molex_SPOX_5267-04A_1x04_P2.50mm_Vertical
J12: ITR-4; Molex_SPOX_5267-04A_1x04_P2.50mm_Vertical
J13: ITR-5; Molex_SPOX_5267-04A_1x04_P2.50mm_Vertical
J14: ITR-6; Molex_SPOX_5267-04A_1x04_P2.50mm_Vertical
J15: ITR-7; Molex_SPOX_5267-04A_1x04_P2.50mm_Vertical
J16: ITR-8; Molex_SPOX_5267-04A_1x04_P2.50mm_Vertical
J17: IR_VCC-1; ARK 01x02 5mm
J18: DaR_VCC; ARK 01x02 5mm
J19: uC_VCC-1; ARK 01x02 5mm
J20: uC_VCC-3; ARK 01x02 5mm
J21: IR_VCC-2; ARK 01x02 5mm
J22: uC_VCC-2; ARK 01x02 5mm
J23: uC_VCC-4; ARK 01x02 5mm
R26, R28, R30, R32, R34, R36, R38, R40: 330R; R_0603_1608Metric_Pad0.98x0.95mm_HandSolder
R27, R29, R31, R33, R35, R37, R39, R41: 22kR; R_0603_1608Metric_Pad0.98x0.95mm_HandSolder

Connections:
+5V: J6.1, J7.1, J7.2, J8.1, J8.2, J9.1, J9.2, J12.1, J12.2, J13.1, J13.2, J14.1, J14.2, J15.1, J15.2, J16.1, J16.2, J17.1, J18.1, J19.1, J20.1, J21.1, J22.1, J23.1; also elsewhere on the board
COMP_IR_01: J10.1; also elsewhere on the board
COMP_IR_02: J10.2; also elsewhere on the board
COMP_IR_03: J10.3; also elsewhere on the board
COMP_IR_04: J10.4; also elsewhere on the board
COMP_IR_05: J11.1; also elsewhere on the board
COMP_IR_06: J11.2; also elsewhere on the board
COMP_IR_07: J11.3; also elsewhere on the board
COMP_IR_08: J11.4; also elsewhere on the board
GND: J6.3, J17.2, J18.2, J19.2, J20.2, J21.2, J22.2, J23.2, R26.2, R27.2, R28.2, R29.2, R30.2, R31.2, R32.2, R33.2, R34.2, R35.2, R36.2, R37.2, R38.2, R39.2, R40.2, R41.2; also elsewhere on the board
unnamed: J7.4, R26.1
unnamed: J8.4, R28.1
unnamed: J9.4, R30.1
unnamed: J12.4, R32.1
unnamed: J13.4, R34.1
unnamed: J14.4, R36.1
unnamed: J15.4, R38.1
unnamed: J16.4, R40.1
SERVO_UDAR_SIG: J6.2
SIGNAL_IR_01: J7.3, R27.1; also elsewhere on the board
SIGNAL_IR_02: J8.3, R29.1; also elsewhere on the board
SIGNAL_IR_03: J9.3, R31.1; also elsewhere on the board
SIGNAL_IR_04: J12.3, R33.1; also elsewhere on the board
SIGNAL_IR_05: J13.3, R35.1; also elsewhere on the board
SIGNAL_IR_06: J14.3, R37.1; also elsewhere on the board
SIGNAL_IR_07: J15.3, R39.1; also elsewhere on the board
SIGNAL_IR_08: J16.3, R41.1; also elsewhere on the board

Notes on the sheet:
Wyjścia zasilania: - 2x13.5V - 2x5V - Czujniki IR - 1x5V - Czujniki odległości - 4x5V - mikrokontrolery - 2X5V - RS485 - 1x5V - Servo - 8x5V - ITR (można zrobić bardziej kompaktowo)(+wejścia sygnału)
Wyjścia zasilania
Wyjścia komparatorów
Enkoder absolutny

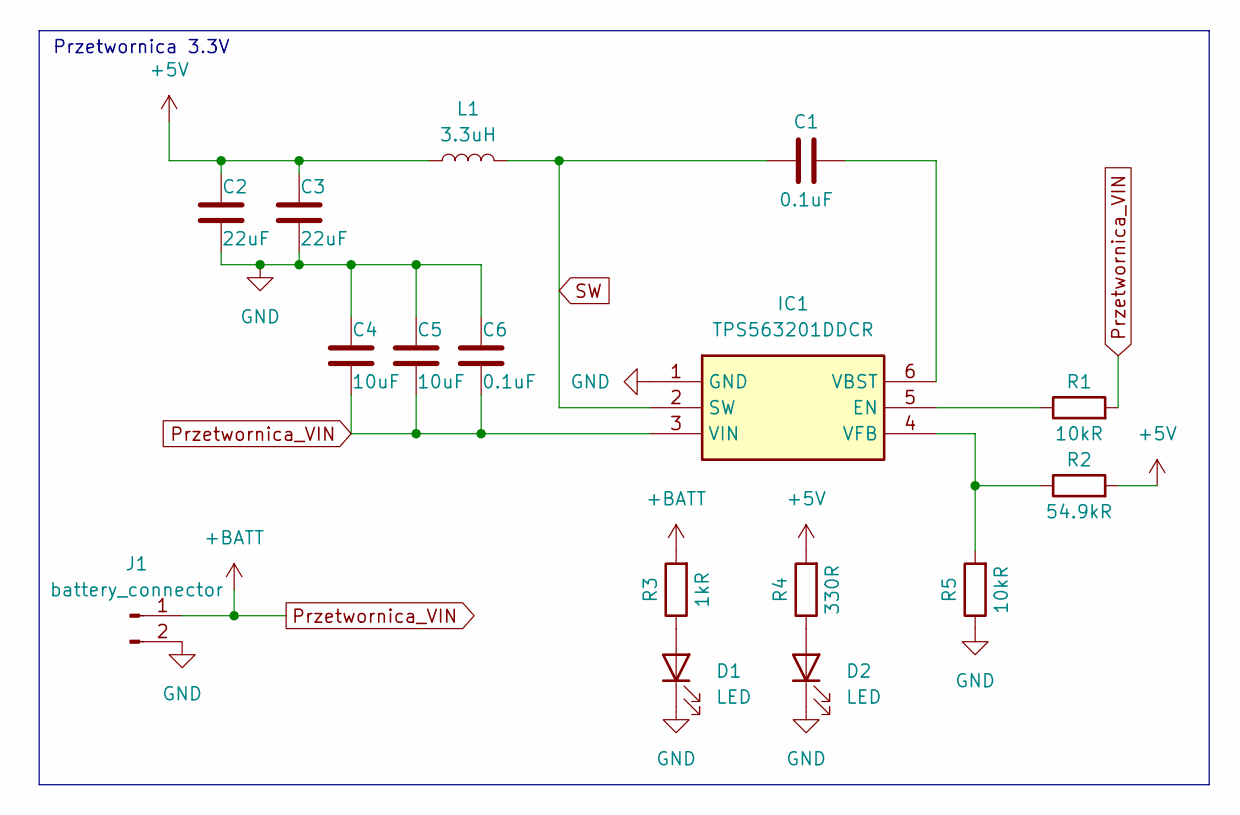
[picture p45: schematic zasilanie.kicad_sch]

Parts:
C1, C6: 0.1uF; C_0603_1608Metric
C2, C3: 22uF; C_0805_2012Metric
C4, C5: 10uF; C_0805_2012Metric
D1, D2: LED; LED_0603_1608Metric_Pad1.05x0.95mm_HandSolder
IC1: TPS563201DDCR; SOT95P280X110-6N; Manufacturer_Part_Number TPS563201DDCR
J1: battery_connector; ARK 01x02 5mm
L1: 3.3uH; L_Bourns_SRP7028A_7.3x6.6mm
R1, R5: 10kR; R_0603_1608Metric_Pad0.98x0.95mm_HandSolder
R2: 54.9kR; R_0603_1608Metric
R3: 1kR; R_0603_1608Metric
R4: 330R; R_0603_1608Metric_Pad0.98x0.95mm_HandSolder

Connections:
+5V: C2.2, C3.2, L1.1, R2.2, R4.2; also elsewhere on the board
GND: C2.1, C3.1, C4.2, C5.2, C6.2, D1.1 (K), D2.1 (K), IC1.1 (GND), J1.2, R5.1; also elsewhere on the board
unnamed: D1.2 (A), R3.1
unnamed: D2.2 (A), R4.1
unnamed: IC1.5 (EN), R1.1
unnamed: C1.2, IC1.6 (VBST)
unnamed: IC1.4 (VFB), R2.1, R5.2
Przetwornica_VIN: C4.1, C5.1, C6.1, IC1.3 (VIN), J1.1, R1.2, R3.2; also elsewhere on the board
SW: C1.1, IC1.2 (SW), L1.2

Notes on the sheet:
Przetwornica 3.3V

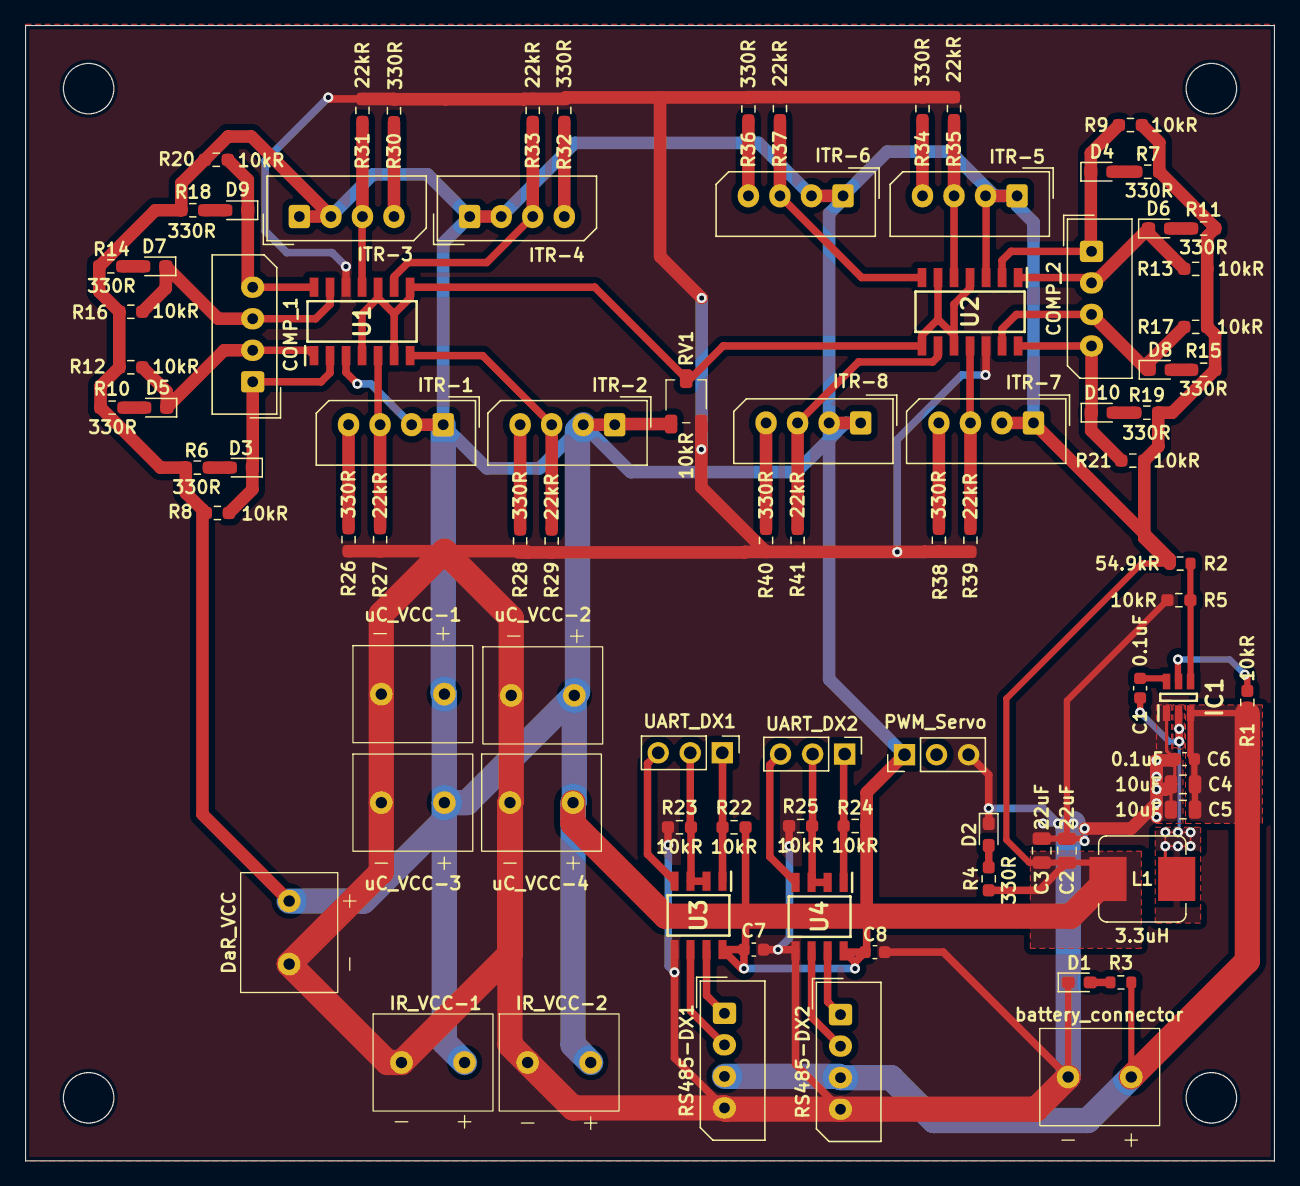
[picture p46: board Projekt elektroniki.kicad_pcb from above]

Board: 2 copper layers, 99.0 x 90.0 mm, 89 parts (0 on the bottom side), 52 nets.
