OliWozniak/uMule/(commit log)

2024-11-24 initial commit
    Podstawowe schematy i projekty
    [22-03-5045.stp, Bidirectional shoulder.STEP, Część1.0002.ipt, Część1.ipt, FG20451.ipt, FG20451.stp, Four directed shoulder.STEP, HC-04HC-04.stl]
2024-12-15 Dodano Regulator_PD.drawio.pdf
2026-04-22 mechanics project cleanup
    [Bidirectional shoulder.STEP, Four directed shoulder.STEP, SlipRing_with_Flange_22mm.f3d, SlipRing_with_Flange_22mm.igs, SlipRing_with_Flange_22mm.ipt, TOF VL53L0X.obj, TOF VL53L0X.stl, TOF VL53L0X.stp]
2026-04-22 file tree reorganisation
    [Część1.ipt, FG20451.ipt, FG20451.stp, Pręt.ipt, frame_rod.ipt, long_frame_rod.ipt, pręt_długi.ipt, rx64H.ipt]
2026-04-22 Working base project. Ready to add modules
    [uMule-wheel_complete.0019.iam, uMule-wheel_complete.0023.iam, uMule-wheel_complete.iam]
2026-04-22 Added current board (simplified model)
    [uMule_board.iam, uMule_board_PCB.ipt, uMule_board_silkscreen.ipt, uMule_board_silkscreen_1.ipt, uMule_board_soldermask.ipt, uMule_board_soldermask_1.ipt]
2026-05-02 added some attachments to 3d models
    [.step 1.21.1.ipt, 2.0_PIN_HEADER.ipt, 2xUSB_2.0_PORT.ipt, 2xUSB_3.0_PORT.ipt, 3.0_PIN_HEADER_10.ipt, 9FD77_D9WHV.ipt, AO_DFN-8-1EP_5.55x5.2mm_P1.27mm_EP4.12x4.6mm.iam, BROADCOM_1.ipt]
2026-05-04 most of attachments is ready. Sent to printing
    [RPI_assembly.0004.iam, RPI_assembly.iam, RPi_case_bottom.0008.ipt, RPi_case_bottom.ipt, RPi_case_bottom.stl, RPi_case_bottom.stp, attachments_hub.0008.ipt, attachments_hub.ipt]
2026-05-24 added ball caster and fixed model
    [ball_caster.ipt, ball_caster_full.iam, ball_for_caster.ipt, uMule-komplet.iam]
2026-05-24 fixed model's orientation
    [attachments_hub.0008.ipt, attachments_hub.0010.ipt, attachments_hub.ipt, uMule-komplet.iam]
